makerbase-motor/MKS-ESP32FOC/README.md

# MKS ESP32 FOC Mega
## This page is for MKS ESP32 FOC Mega, which is different from MKS ESC32 FOC V1.0 and MKS ESC32 FOC V2.0, please be careful to distinguish.
### [If your motherboard is MKS ESP32 FOC V1.0, please click here to jump.](https://github.com/makerbase-motor/MKS-ESP32FOC/tree/MKS-ESP32-FOC-V1.0)

### [If your motherboard is MKS ESP32 FOC V2.0, please click here to jump.](https://github.com/makerbase-motor/MKS-ESP32FOC/tree/MKS-ESP32-FOC-V2.0)
MKS ESP32 FOC is an integrated motherboard designed based on simple FOC, which supports dual motor control.

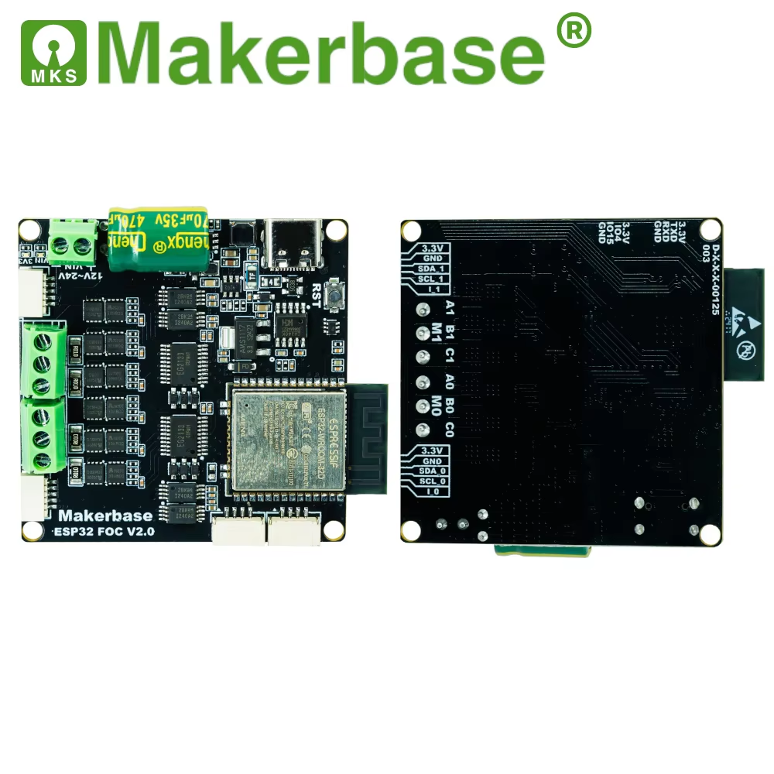
[picture p1: image/MKS ESP32 FOC V2.0.png]
mks ESP32 FOC V2.0


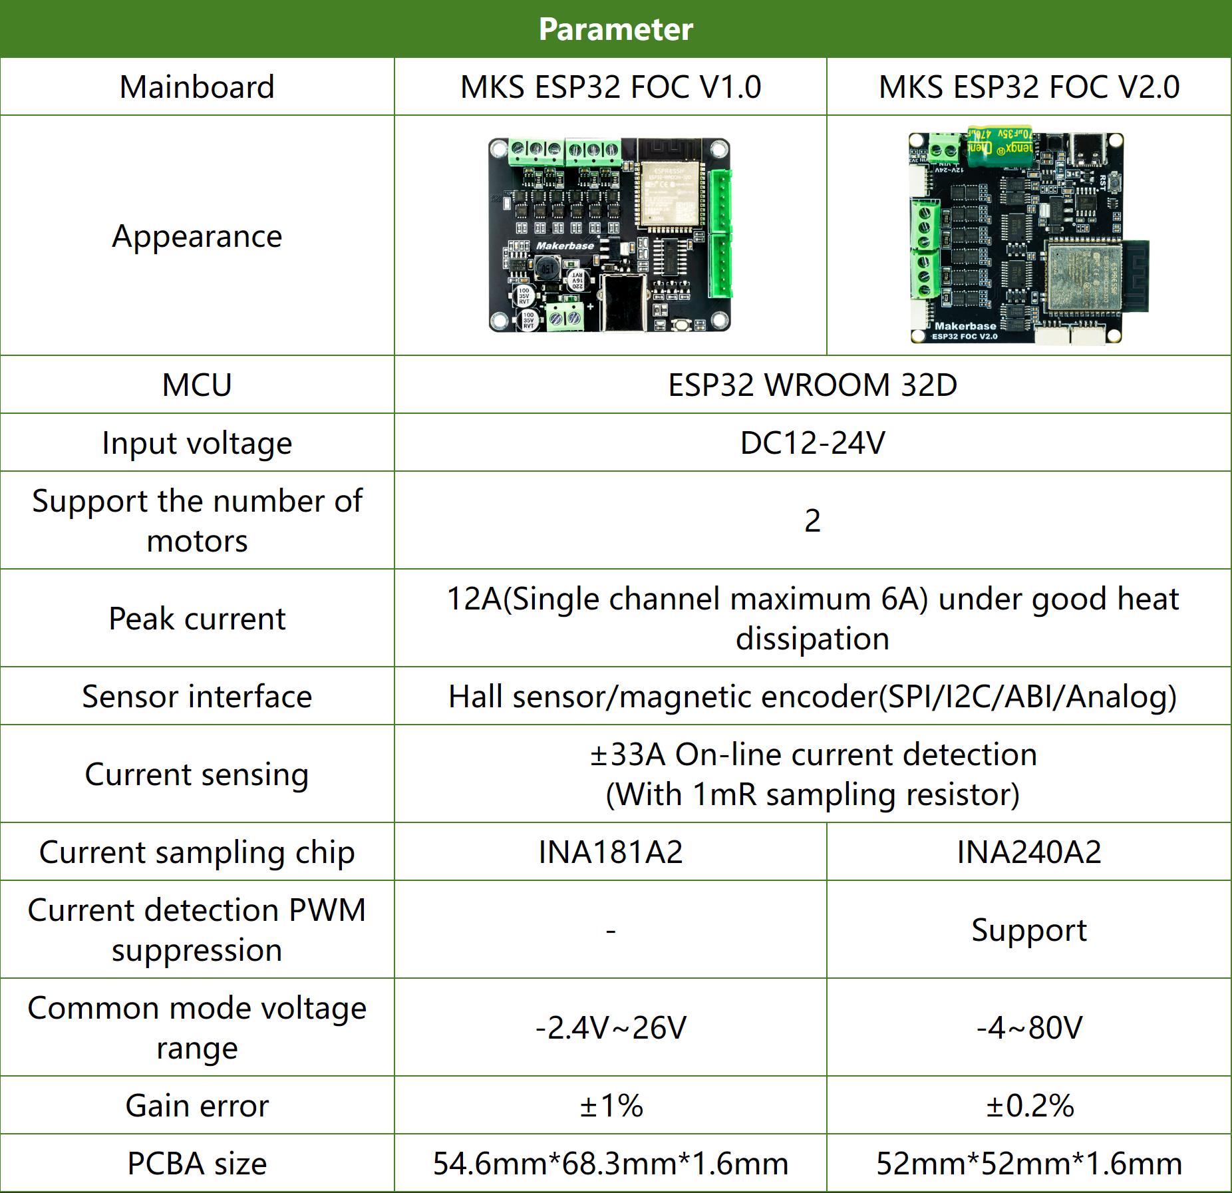
[picture p2: image/FireShot Capture 874 - MKS ESP32 FOC EN v2.png]
Compare


## How to buy
[Aliexpress Store](https://vi.aliexpress.com/item/3256805324882671.html?gatewayAdapt=glo2vnm)
