makerbase-motor/MKS-ESP32FOC/(threads)

Thread 1 (2024-08-07):

Example settings to use for Platformio?

MostHated, 2024-08-07:
Hey there, I was wondering if you happen to have an example of what settings would need to be used for platformio for this controller/board?

MostHated, 2024-08-17:
Also, is there no way to access RX/TX for CANBus?

Thread 3 (2025-07-08):

Openloop velocity example doesn't work with v2 board

bogdanr, 2025-07-08:
External power supply set at 15V, 4A.
I get the following error when I try to run the code without the motors being attached:

```

rst:0xc (SW_CPU_RESET),boot:0x13 (SPI_FAST_FLASH_BOOT)
configsip: 0, SPIWP:0xee
clk_drv:0x00,q_drv:0x00,d_drv:0x00,cs0_drv:0x00,hd_drv:0x00,wp_drv:0x00
mode:DIO, clock div:1
load:0x3fff0030,len:4888
load:0x40078000,len:16516
load:0x40080400,len:4
load:0x40080404,len:3476
entry 0x400805b4
Calibrating motor...Current voltage15.27
E (7) mcpwm: mcpwm_new_timer(106): register back up is not supported
E (8) mcpwm: mcpwm_new_timer(106): register back up is not supported
Motor ready!
Set target velocity [rad/s]
Guru Meditation Error: Core  1 panic'ed (LoadProhibited). Exception was unhandled.

Core  1 register dump:
PC      : 0x400d56c7  PS      : 0x00060730  A0      : 0x800d398c  A1      : 0x3ffb21d0
A2      : 0x00000000  A3      : 0x00000000  A4      : 0x00000000  A5      : 0xffffffff
A6      : 0x3ffc2d2c  A7      : 0x3ffb21ac  A8      : 0x800e94d8  A9      : 0x3ffb2160
A10     : 0x00000000  A11     : 0x000001f0  A12     : 0x3ffb21d4  A13     : 0x3f40cfb8
A14     : 0x00000000  A15     : 0x3ffb8c5c  SAR     : 0x0000001d  EXCCAUSE: 0x0000001c
EXCVADDR: 0x0000004b  LBEG    : 0x400029ac  LEND    : 0x400029cb  LCOUNT  : 0x00000000

Backtrace: 0x400d56c4:0x3ffb21d0 0x400d3989:0x3ffb21f0 0x400fe8a1:0x3ffb2210 0x400d203e:0x3ffb2230 0x400d2067:0x3ffb2250 0x400d8928:0x3ffb2270 0x400892ce:0x3ffb2290

ELF file SHA256: 1267c4139

Rebooting...

```

I don't exclude that the board is defective because when the code runs it looks like it's drawing a lot of current for 20ms before it crashes.

bogdanr, 2025-07-12:
The issue was with ESP-IDF version. Doesn't work with 3.2.1.

Closed 2025-07-12.
