makerbase-motor/MKS-ESP32FOC/Hardware/MKS ESP32 FOC Mega_SCH.pdf

# DC INPUT DC-DC 3.3V

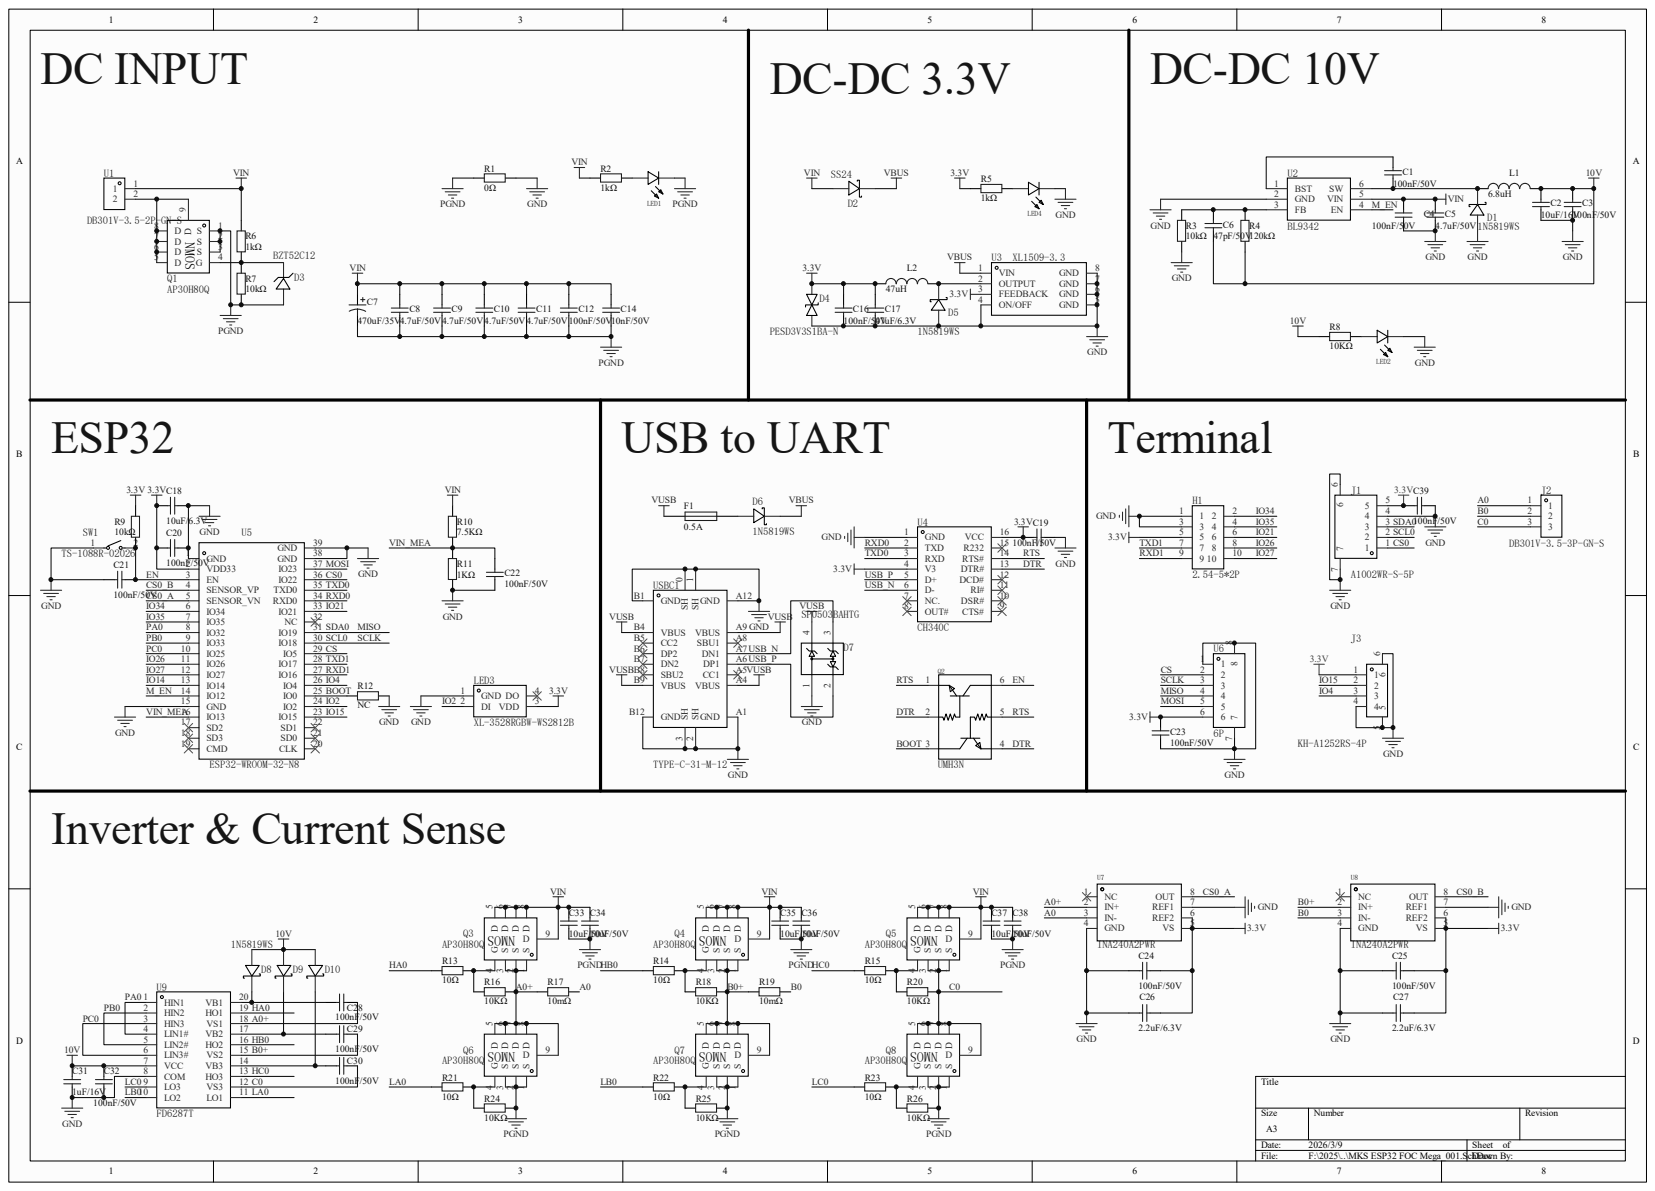
[picture p10: page 1]
