makerbase-motor/MKS-ESP32FOC/Hardware/MKS ESP32 FOC V2.0_SCH.pdf

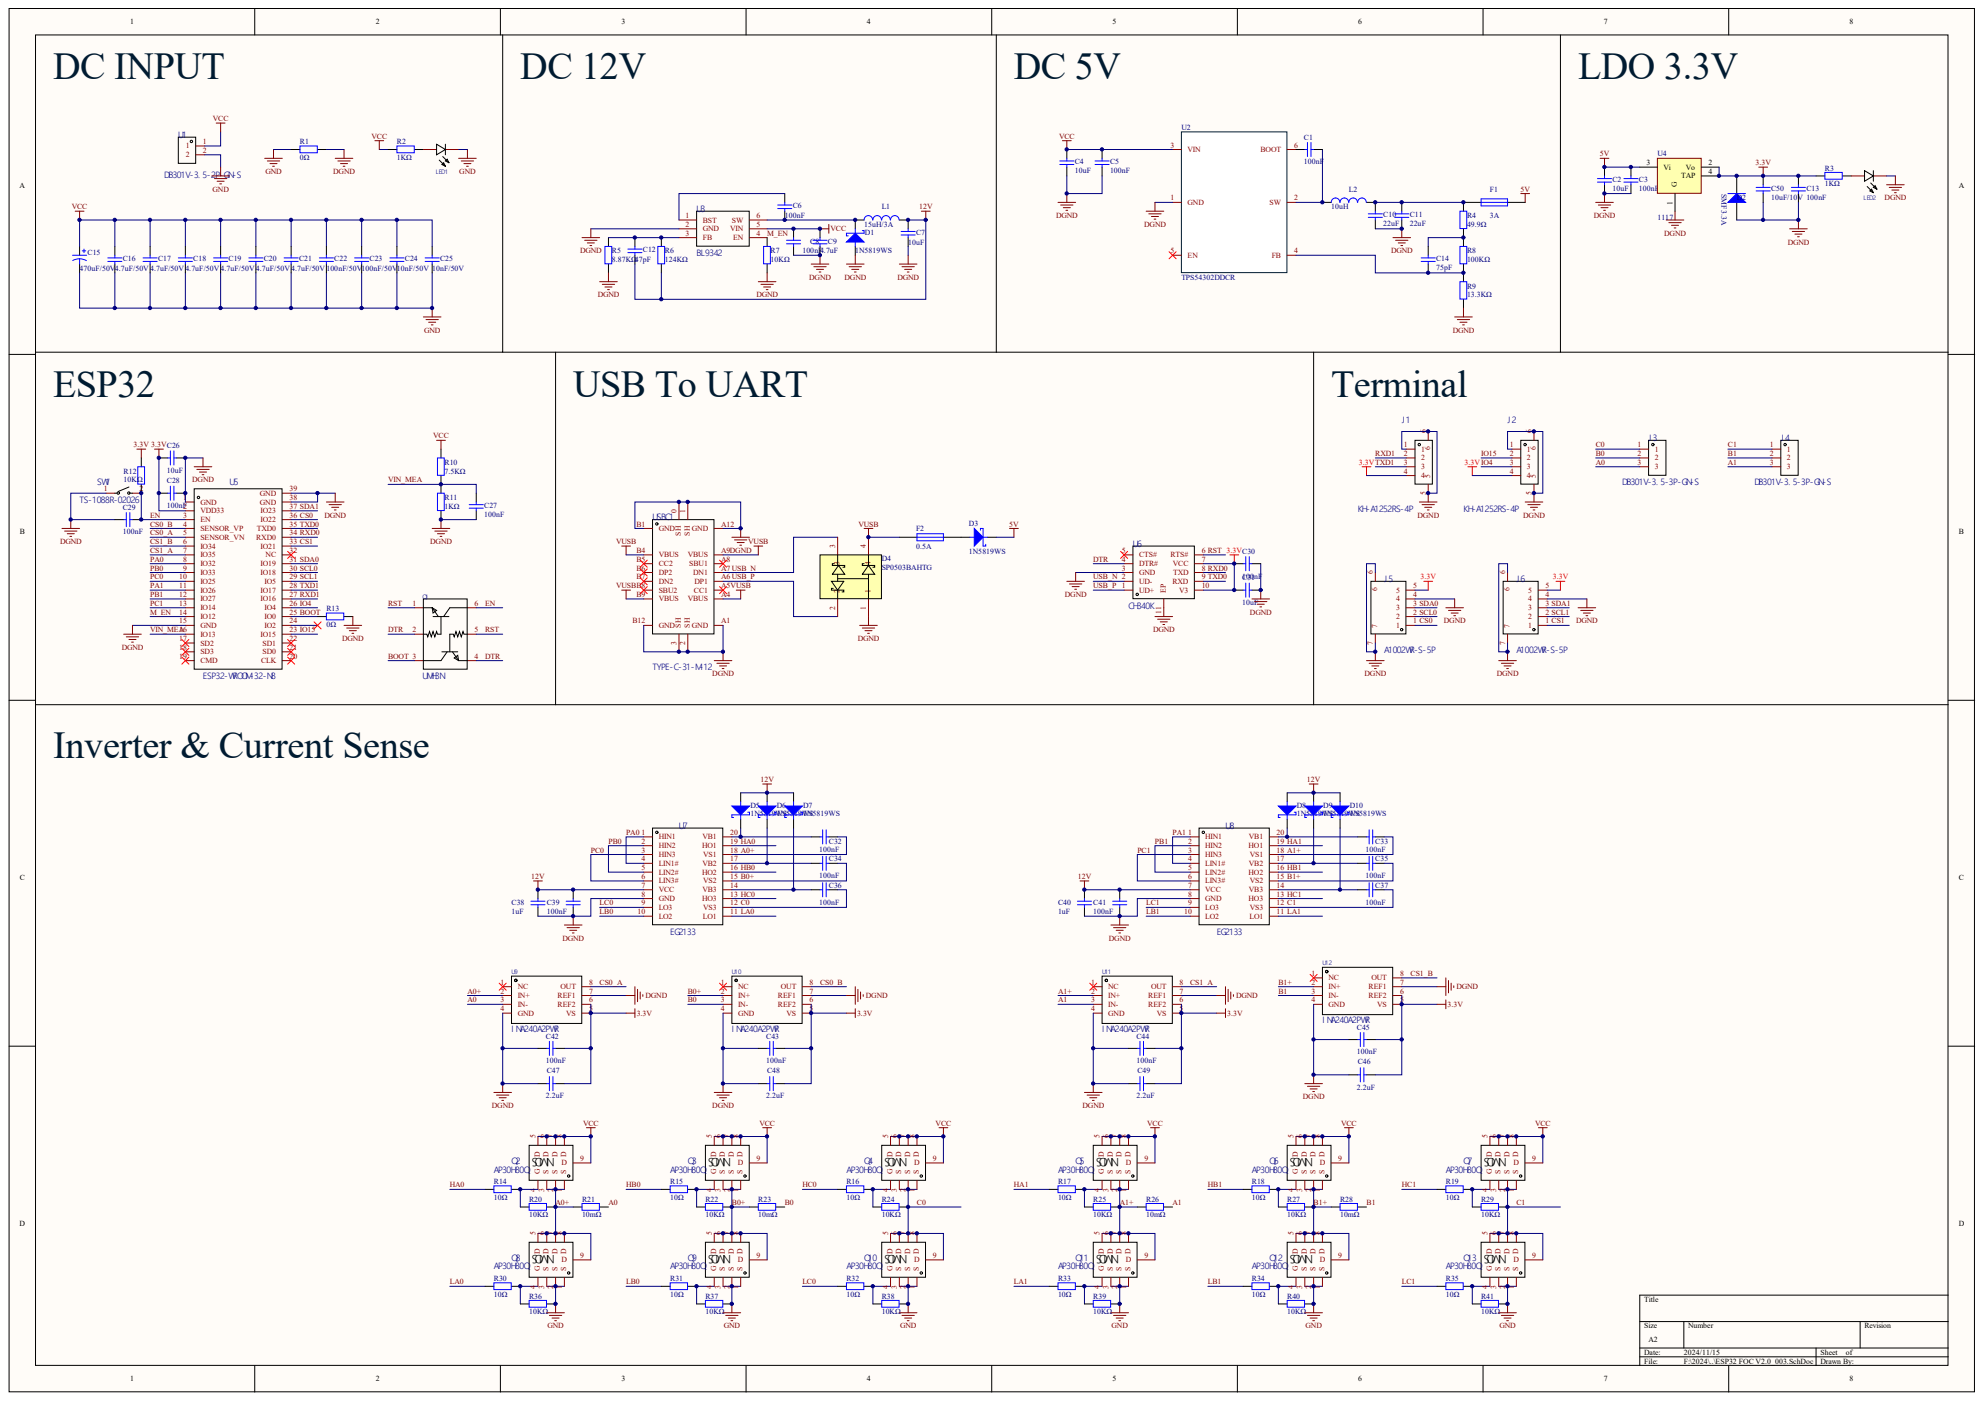
[picture p11: page 1]
