makerbase-motor/MKS-ESP32FOC/Hardware/MKS ESP32 FOC V1.0_SCH.pdf

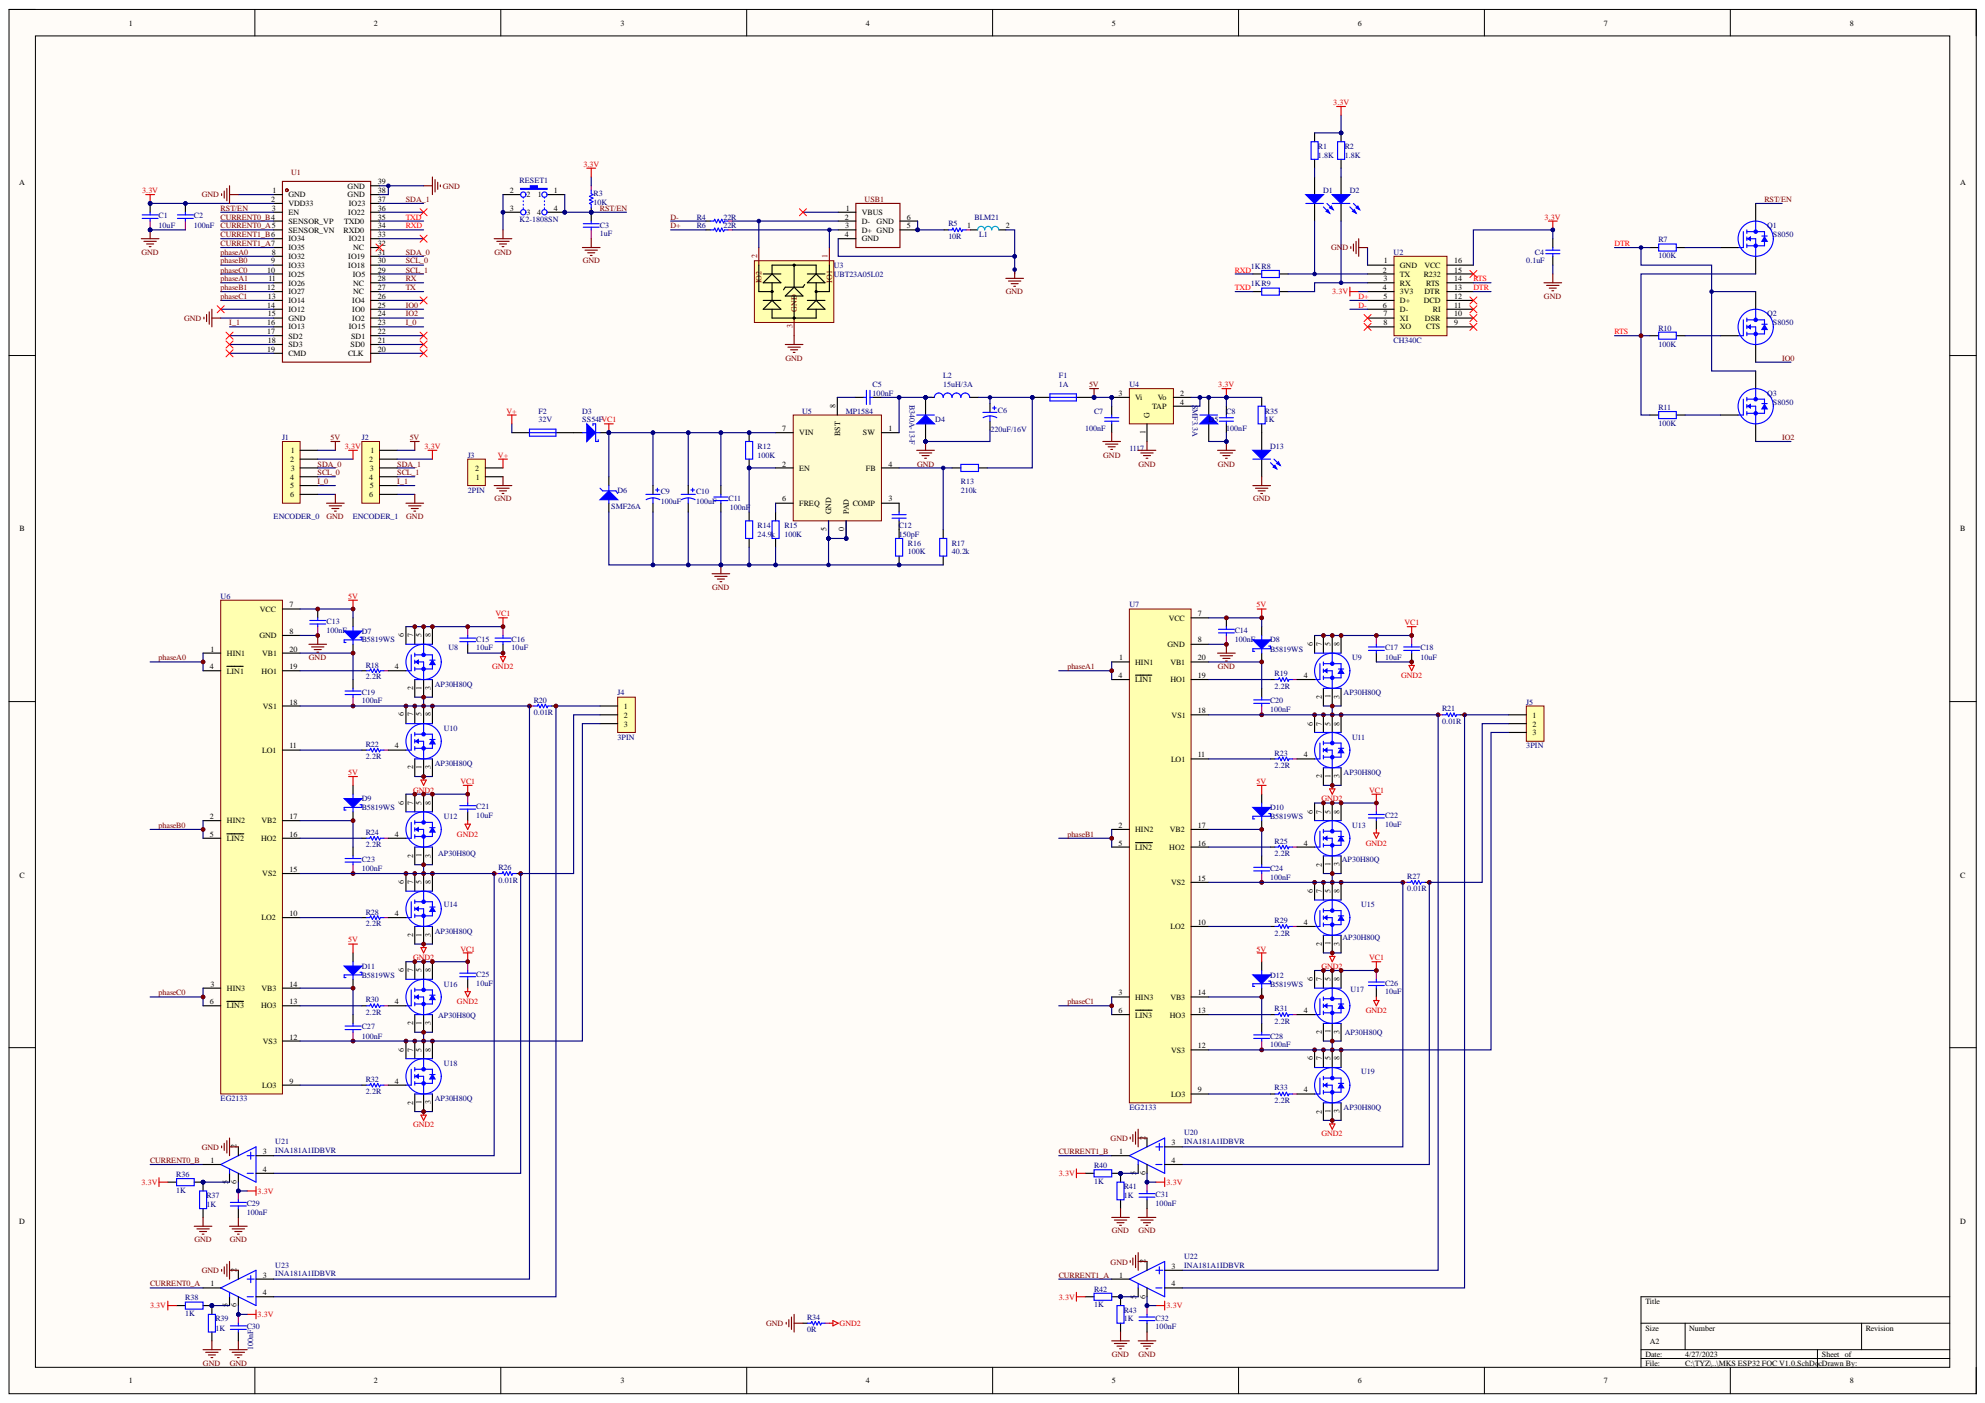
[picture p12: page 1]

4 | GND
